kcl93/LED_Strahler/LED_Strahler_Case/LED_Strahler_Top.stl

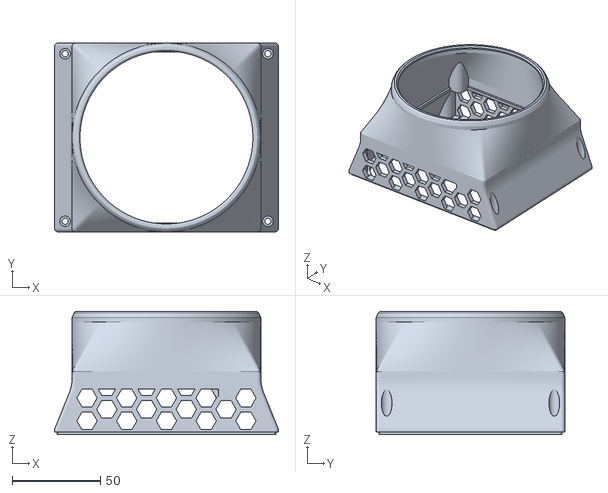
[picture p1: CAD file, 2020-01-30]
LED_Strahler_Case/LED_Strahler_Top.stl
127.0 x 107.0 x 69.9
