kcl93/LED_Strahler/LED_Strahler_Case/LED_Strahler_Bottom_NoDMX.stl

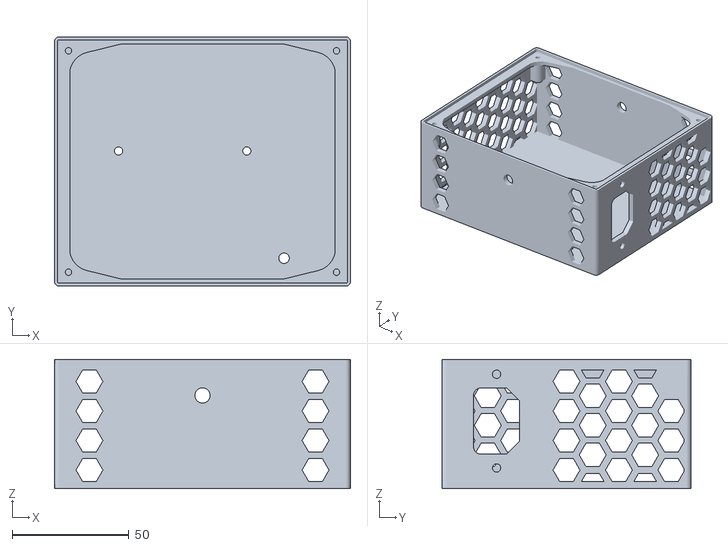
[picture p2: CAD file, 2020-01-22]
LED_Strahler_Case/LED_Strahler_Bottom_NoDMX.stl
127.0 x 107.0 x 55.5
