kcl93/LED_Strahler/LED_Strahler_Case/LED_Strahler_Reflektor.stl

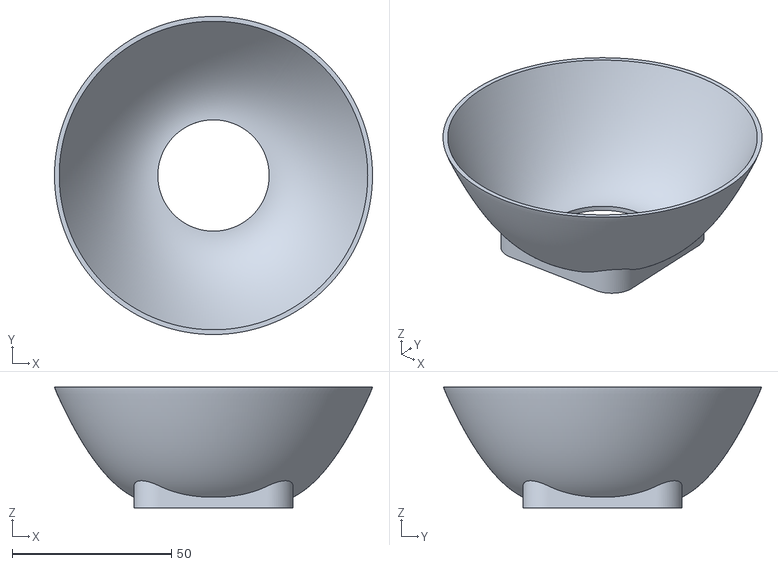
[picture p3: CAD file, 2020-01-22]
LED_Strahler_Case/LED_Strahler_Reflektor.stl
100.0 x 100.0 x 38.0
