kcl93/LED_Strahler/LED_Strahler_Case/Luefter_Stoepsel.stl

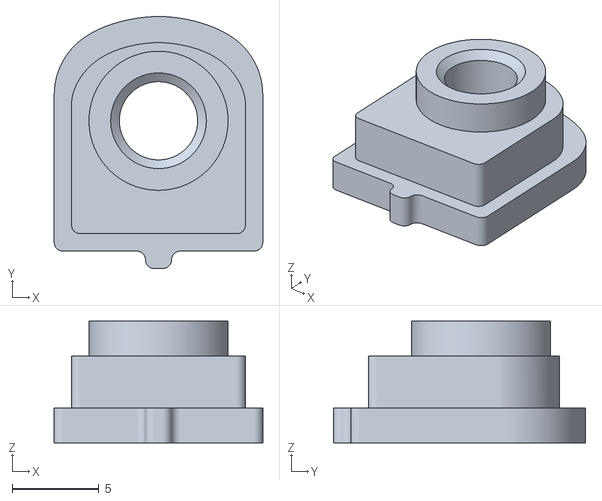
[picture p4: CAD file, 2020-01-22]
LED_Strahler_Case/Luefter_Stoepsel.stl
12.0 x 14.5 x 7.00
