kcl93/LED_Strahler/LED_Strahler_PCB/LED_Strahler/LED_Strahler.kicad_pcb

## KiCad design LED_Strahler_PCB/LED_Strahler/LED_Strahler.kicad_pcb (2020-01-12)

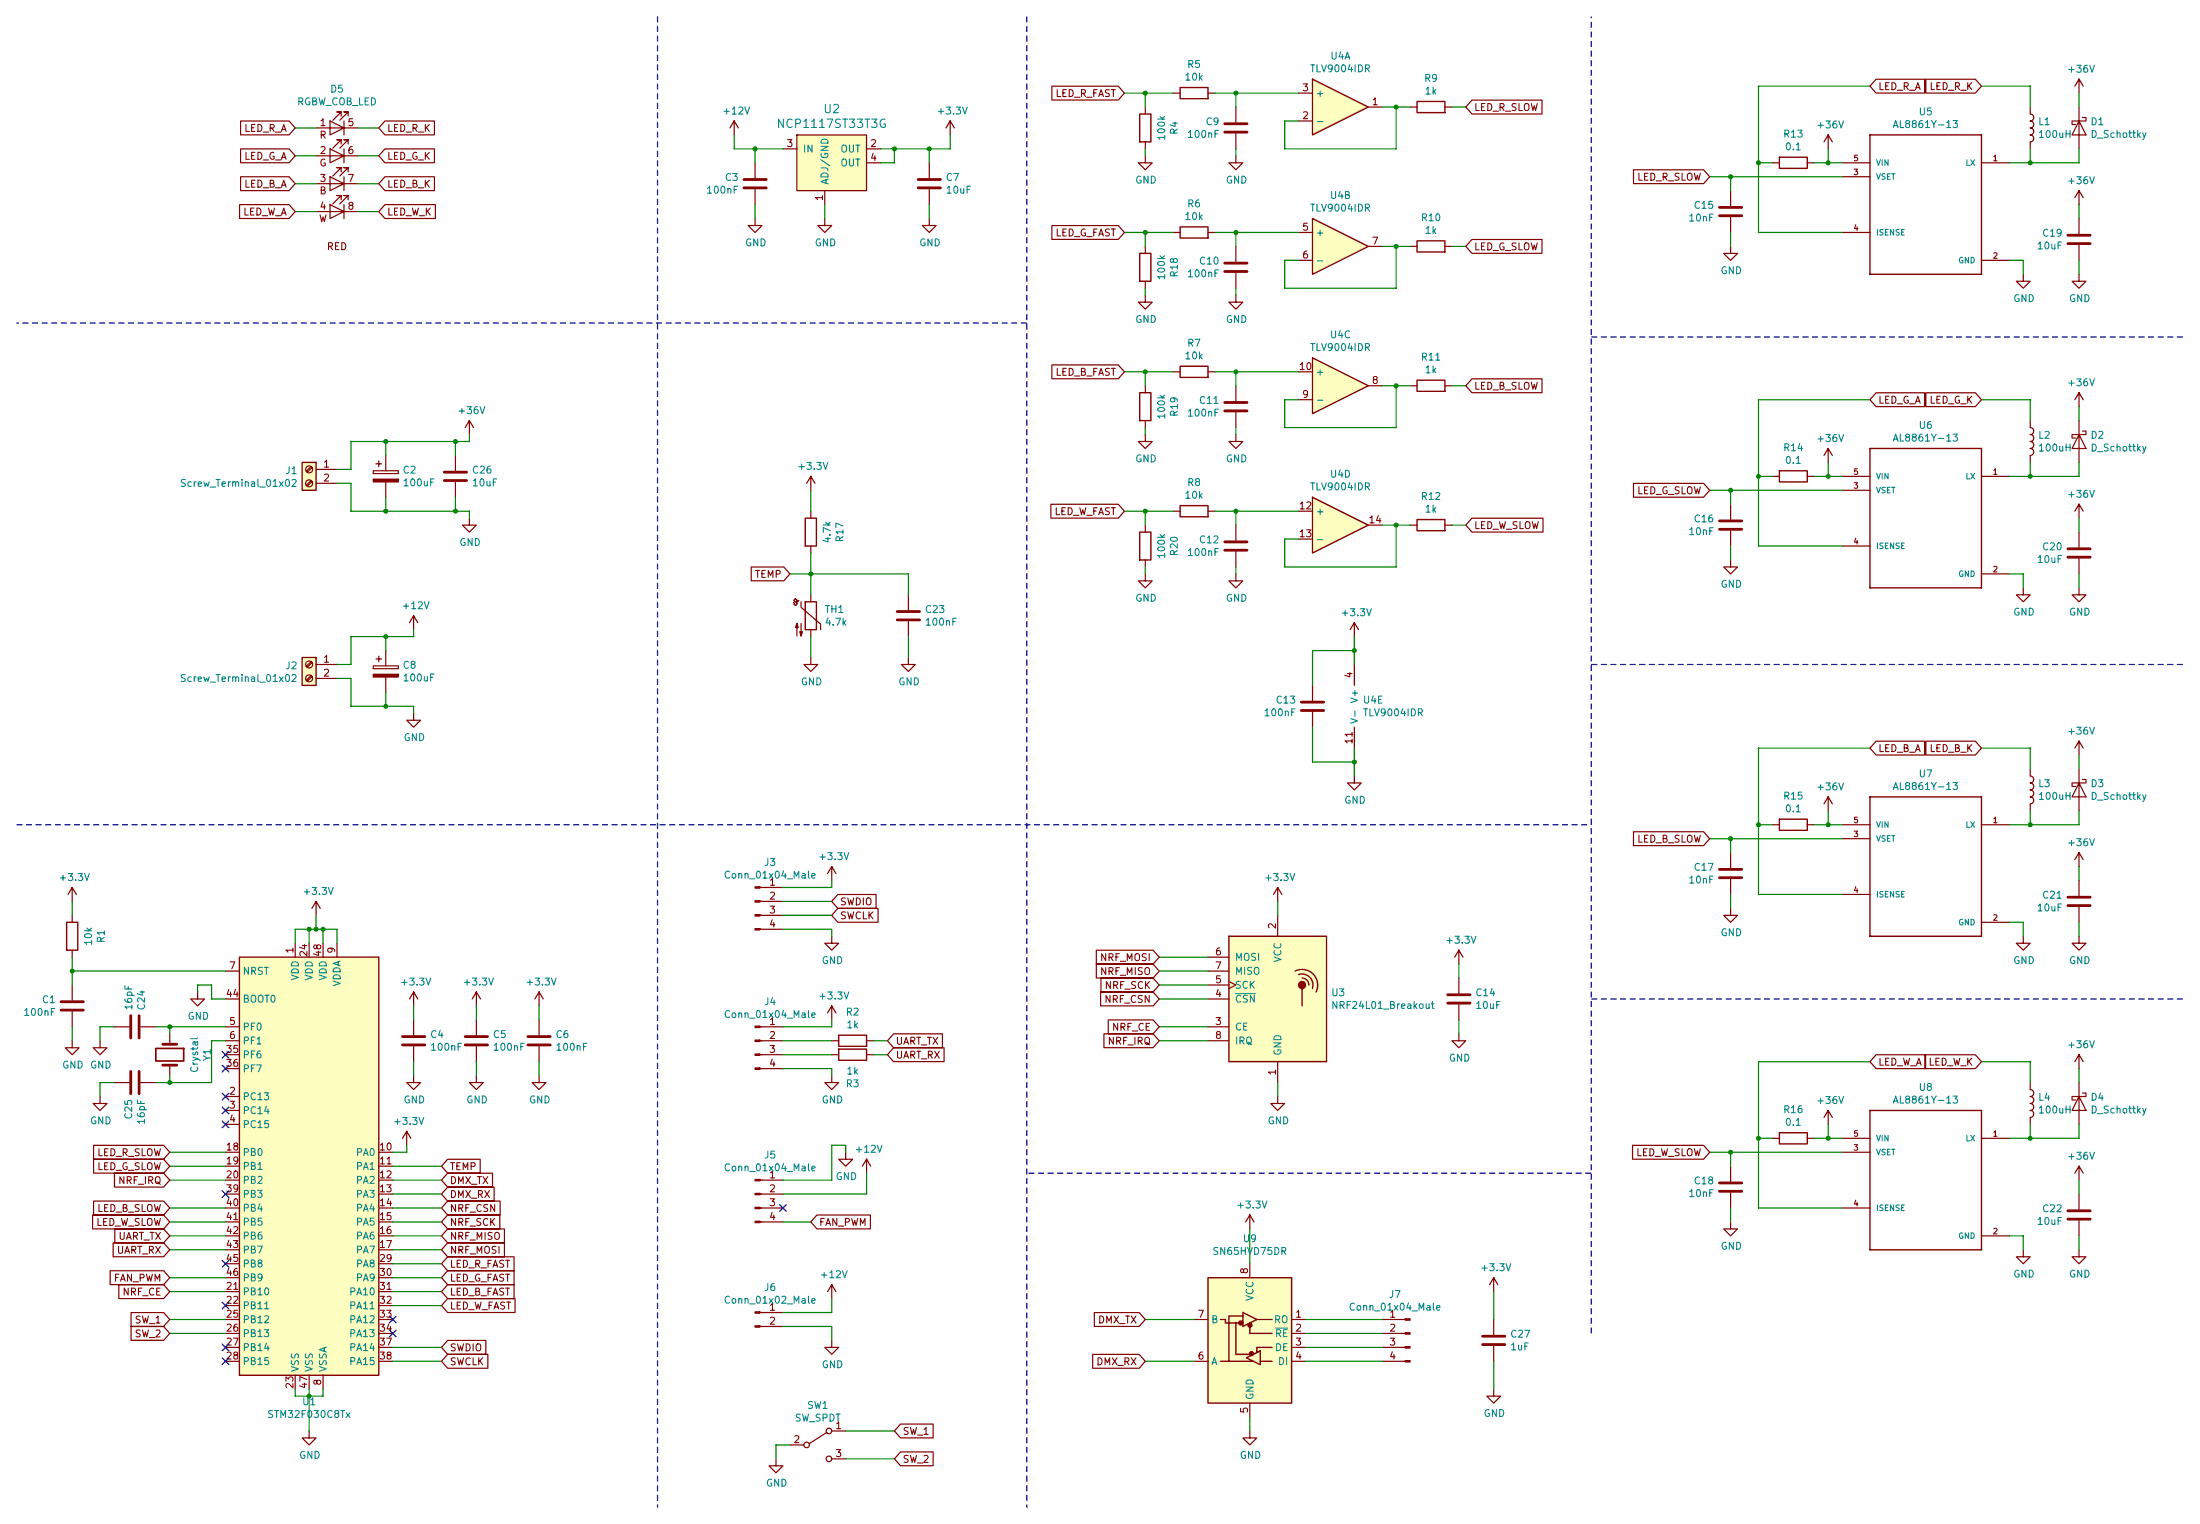
[picture p6: schematic LED_Strahler.sch, LED Strahler]

Parts:
C1, C3, C4, C5, C6, C9, C10, C11, C12, C13, C23: 100nF; C_0603_1608Metric_Pad1.05x0.95mm_HandSolder
C2, C8: 100uF; CP_Radial_D10.0mm_P5.00mm
C7, C14: 10uF; C_0805_2012Metric_Pad1.15x1.40mm_HandSolder
C15, C16, C17, C18: 10nF; C_0603_1608Metric_Pad1.05x0.95mm_HandSolder
C19, C20, C21, C22, C26: 10uF; C_1210_3225Metric_Pad1.42x2.65mm_HandSolder
C24, C25: 16pF; C_0603_1608Metric_Pad1.05x0.95mm_HandSolder
C27: 1uF; C_0805_2012Metric_Pad1.15x1.40mm_HandSolder
D1, D2, D3, D4: D_Schottky; D_SOD-123F
D5: RGBW_COB_LED; 50W_RGBW_COB_LED
J1, J2: Screw_Terminal_01x02; AMASS_XT30U-F_1x02_P5.0mm_Vertical
J3, J4, J7: Conn_01x04_Male; PinHeader_1x04_P2.54mm_Vertical
J5: Conn_01x04_Male; FanPinHeader_1x04_P2.54mm_Vertical
J6: Conn_01x02_Male; PinHeader_1x02_P2.54mm_Vertical
L1, L2, L3, L4: 100uH; L_Bourns_SRR1260
R1, R5, R6, R7, R8: 10k; R_0603_1608Metric_Pad1.05x0.95mm_HandSolder
R2, R3, R9, R10, R11, R12: 1k; R_0603_1608Metric_Pad1.05x0.95mm_HandSolder
R4, R18, R19, R20: 100k; R_0603_1608Metric_Pad1.05x0.95mm_HandSolder
R13, R14, R15, R16: 0.1; R_0805_2012Metric_Pad1.15x1.40mm_HandSolder
R17: 4.7k; R_0603_1608Metric_Pad1.05x0.95mm_HandSolder
SW1: SW_SPDT; SW_CuK_OS102011MA1QN1_SPDT_Angled
TH1: 4.7k; R_0603_1608Metric_Pad1.05x0.95mm_HandSolder
U1: STM32F030C8Tx; LQFP-48_7x7mm_P0.5mm
U2: NCP1117ST33T3G; SOT-223; MPN NCP1117ST33T3G; Digi-Key_PN NCP1117ST33T3GOSCT-ND
U3: NRF24L01_Breakout; nRF24L01_Breakout
U4: TLV9004IDR; SOIC-14_3.9x8.7mm_P1.27mm
U5, U6, U7, U8: AL8861Y-13; CONV_AL8861Y-13
U9: SN65HVD75DR; SOIC-8_3.9x4.9mm_P1.27mm
Y1: Crystal; Crystal_SMD_HC49-SD

Connections:
+3V3: C4.1, C5.1, C6.1, C7.1, C13.1, C14.1, C27.1, J3.1, J4.1, R1.1, R17.1, U1.1 (VDD), U1.9 (VDDA), U1.10 (PA0), U1.24 (VDD), U1.48 (VDD), U2.2 (OUT), U2.4 (OUT), U3.2 (VCC), U4.4 (V+), U9.8 (VCC)
+12V: C3.1, C8.1, J2.1, J5.2, J6.1, U2.3 (IN)
+36V: C2.1, C19.1, C20.1, C21.1, C22.1, C26.1, D1.1 (K), D2.1 (K), D3.1 (K), D4.1 (K), J1.1, R13.1, R14.1, R15.1, R16.1, U5.5 (VIN), U6.5 (VIN), U7.5 (VIN), U8.5 (VIN)
DMX_RX: U1.13 (PA3), U9.6 (A)
DMX_TX: U1.12 (PA2), U9.7 (B)
FAN_PWM: J5.4, U1.46 (PB9)
GND: C1.2, C2.2, C3.2, C4.2, C5.2, C6.2, C7.2, C8.2, C9.2, C10.2, C11.2, C12.2, C13.2, C14.2, C15.2, C16.2, C17.2, C18.2, C19.2, C20.2, C21.2, C22.2, C23.2, C24.2, C25.1, C26.2, C27.2, J1.2, J2.2, J3.4, J4.4, J5.1, J6.2, R4.2, R18.2, R19.2, R20.2, SW1.2 (B), TH1.2, U1.8 (VSSA), U1.23 (VSS), U1.44 (BOOT0), U1.47 (VSS), U2.1 (ADJ/GND), U3.1 (GND), U4.11 (V-), U5.2 (GND), U6.2 (GND), U7.2 (GND), U8.2 (GND), U9.5 (GND)
LED_B_A: D5.3 (A), R15.2, U7.4 (ISENSE)
LED_B_FAST: R7.1, R19.1, U1.31 (PA10)
LED_B_K: D5.7 (K), L3.1
LED_B_SLOW: C17.1, R11.2, U1.40 (PB4), U7.3 (VSET)
LED_G_A: D5.2 (A), R14.2, U6.4 (ISENSE)
LED_G_FAST: R6.1, R18.1, U1.30 (PA9)
LED_G_K: D5.6 (K), L2.1
LED_G_SLOW: C16.1, R10.2, U1.19 (PB1), U6.3 (VSET)
LED_R_A: D5.1 (A), R13.2, U5.4 (ISENSE)
LED_R_FAST: R4.1, R5.1, U1.29 (PA8)
LED_R_K: D5.5 (K), L1.1
LED_R_SLOW: C15.1, R9.2, U1.18 (PB0), U5.3 (VSET)
LED_W_A: D5.4 (A), R16.2, U8.4 (ISENSE)
LED_W_FAST: R8.1, R20.1, U1.32 (PA11)
LED_W_K: D5.8 (K), L4.1
LED_W_SLOW: C18.1, R12.2, U1.41 (PB5), U8.3 (VSET)
NRF_CE: U1.21 (PB10), U3.3 (CE)
NRF_CSN: U1.14 (PA4), U3.4 (~CSN)
NRF_IRQ: U1.20 (PB2), U3.8 (IRQ)
NRF_MISO: U1.16 (PA6), U3.7 (MISO)
NRF_MOSI: U1.17 (PA7), U3.6 (MOSI)
NRF_SCK: U1.15 (PA5), U3.5 (SCK)
unnamed: C1.1, R1.2, U1.7 (NRST)
unnamed: C9.1, R5.2, U4.3 (+)
unnamed: C10.1, R6.2, U4.5 (+)
unnamed: C11.1, R7.2, U4.10 (+)
unnamed: C12.1, R8.2, U4.12 (+)
unnamed: C24.1, U1.5 (PF0), Y1.1
unnamed: C25.2, U1.6 (PF1), Y1.2
unnamed: D1.2 (A), L1.2, U5.1 (LX)
unnamed: D2.2 (A), L2.2, U6.1 (LX)
unnamed: D3.2 (A), L3.2, U7.1 (LX)
unnamed: D4.2 (A), L4.2, U8.1 (LX)
unnamed: J4.2, R2.1
unnamed: J4.3, R3.2
unnamed: J7.1, U9.1 (RO)
unnamed: J7.2, U9.2 (~RE)
unnamed: J7.3, U9.3 (DE)
unnamed: J7.4, U9.4 (DI)
unnamed: R9.1, U4.1, U4.2 (-)
unnamed: R10.1, U4.6 (-), U4.7
unnamed: R11.1, U4.8, U4.9 (-)
unnamed: R12.1, U4.13 (-), U4.14
SWCLK: J3.3, U1.38 (PA15)
SWDIO: J3.2, U1.37 (PA14)
SW_1: SW1.1 (A), U1.25 (PB12)
SW_2: SW1.3 (C), U1.26 (PB13)
TEMP: C23.1, R17.2, TH1.1, U1.11 (PA1)
UART_RX: R3.1, U1.43 (PB7)
UART_TX: R2.2, U1.42 (PB6)

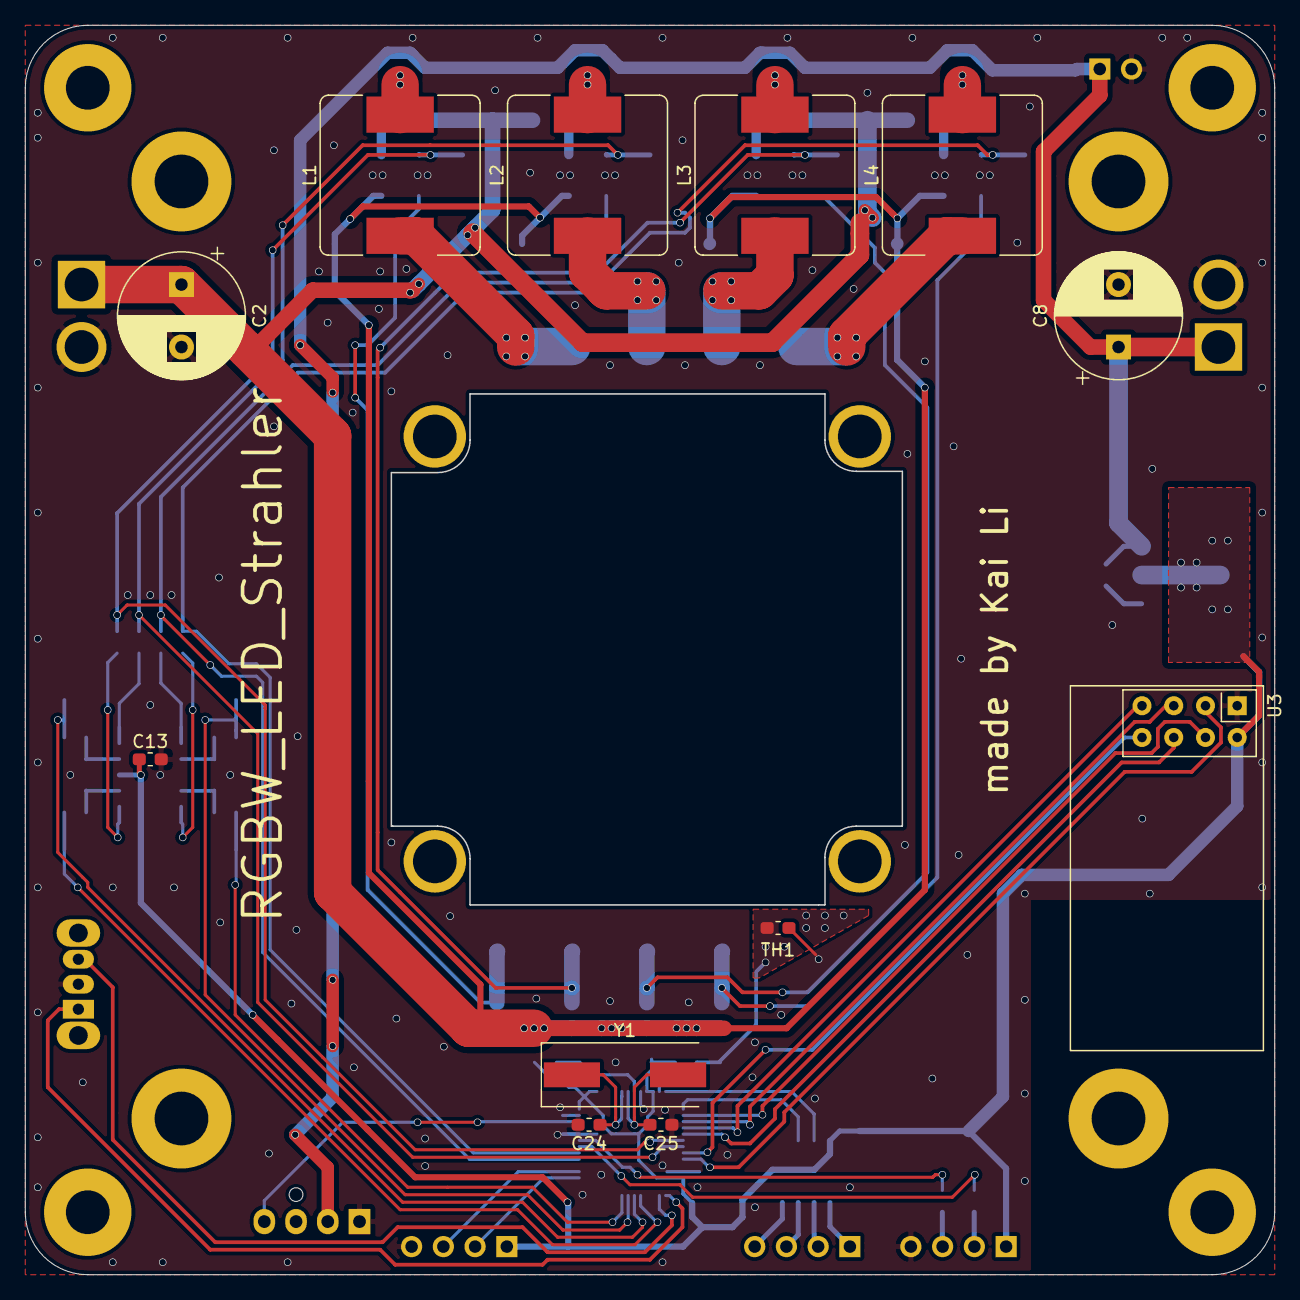
[picture p7: board LED_Strahler.kicad_pcb from above]

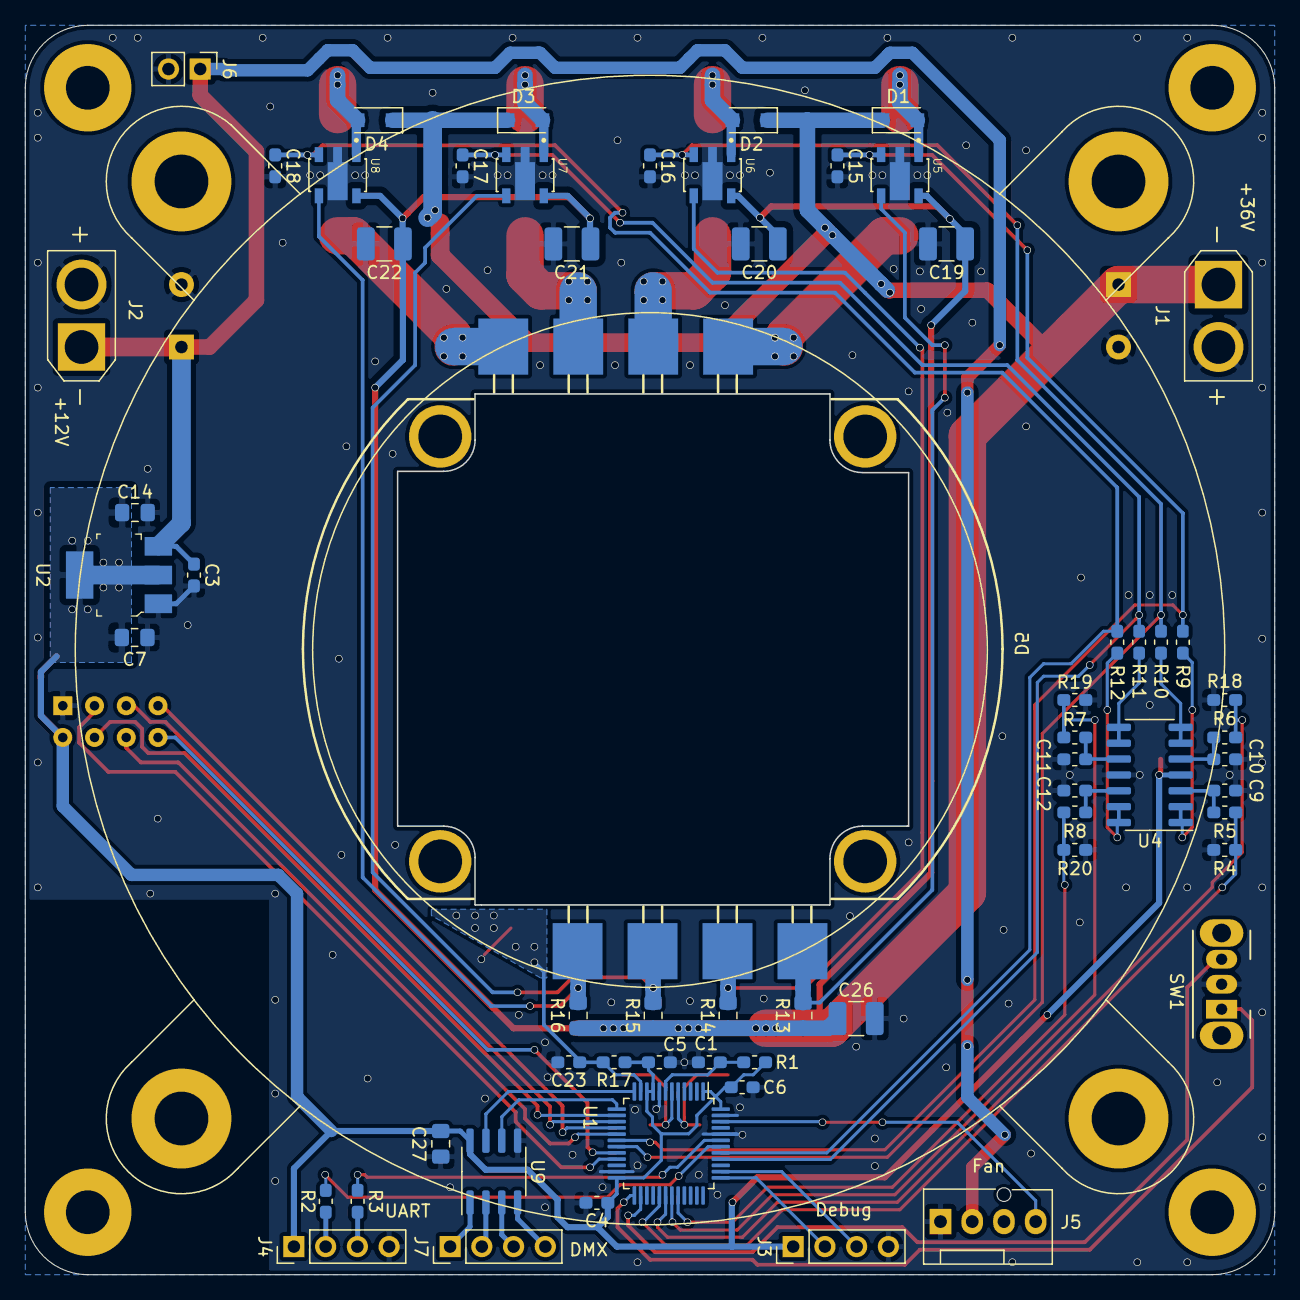
[picture p8: board LED_Strahler.kicad_pcb from below]

Board: 2 copper layers, 100.0 x 100.0 mm, 75 parts (62 on the bottom side), 57 nets.
