kcl93/LED_Strahler/LED_Strahler_FW/LED_Strahler/LED_Strahler.ioc

Mcu.UserName=STM32F030C8Tx
PA1.GPIO_Label=TEMP
PA1.Signal=ADC_IN1
PA10.GPIO_Label=LED_B_FAST
PA10.Signal=S_TIM1_CH3
PA11.GPIO_Label=LED_W_FAST
PA11.Signal=S_TIM1_CH4
PA13.Signal=SYS_SWDIO
PA14.Signal=SYS_SWCLK
PA2.GPIO_Label=DMX_TX
PA2.Signal=USART2_TX
PA3.GPIO_Label=DMX_RX
PA3.Signal=USART2_RX
PA4.GPIO_Label=NRF_CSN
PA4.Signal=GPIO_Output
PA5.GPIO_Label=NRF_SCK
PA5.Signal=SPI1_SCK
PA6.GPIO_Label=NRF_MISO
PA6.Signal=SPI1_MISO
PA7.GPIO_Label=NRF_MOSI
PA7.Signal=SPI1_MOSI
PA8.GPIO_Label=LED_R_FAST
PA8.Signal=S_TIM1_CH1
PA9.GPIO_Label=LED_G_FAST
PA9.Signal=S_TIM1_CH2
PB0.GPIO_Label=LED_R_SLOW
PB0.Signal=S_TIM3_CH3
PB1.GPIO_Label=LED_G_SLOW
PB1.Signal=S_TIM3_CH4
PB10.GPIO_Label=NRF_CE
PB10.Signal=GPIO_Output
PB12.GPIO_Label=SW_1
PB12.Signal=GPIO_Input
PB13.GPIO_Label=SW_2
PB13.Signal=GPIO_Input
PB2.GPIO_Label=NRF_IRQ
PB2.Signal=GPXTI2
PB4.GPIO_Label=LED_B_SLOW
PB4.Signal=S_TIM3_CH1
PB5.GPIO_Label=LED_W_SLOW
PB5.Signal=S_TIM3_CH2
PB6.GPIO_Label=UART_TX
PB6.Signal=USART1_TX
PB7.GPIO_Label=UART_RX
PB7.Signal=USART1_RX
PB9.GPIO_Label=FAN_PWM
PB9.Signal=S_TIM17_CH1
PF0-OSC_IN.GPIO_Label=OSC_IN
PF0-OSC_IN.Signal=RCC_OSC_IN
PF1-OSC_OUT.GPIO_Label=OSC_OUT
PF1-OSC_OUT.Signal=RCC_OSC_OUT
