kcl93/LED_Strahler/LED_Base_FW/LED_Strahler_Base/Core/Src/main.cpp

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

/* Includes ------------------------------------------------------------------*/
#include "main.h"

/* USER CODE BEGIN Includes */
#include "LED_Base.h"
/* USER CODE END Includes */

ADC_HandleTypeDef hadc2;

OPAMP_HandleTypeDef hopamp2;

SPI_HandleTypeDef hspi2;

UART_HandleTypeDef huart2;
UART_HandleTypeDef huart3;
DMA_HandleTypeDef hdma_usart2_rx;
DMA_HandleTypeDef hdma_usart2_tx;
DMA_HandleTypeDef hdma_usart3_rx;
DMA_HandleTypeDef hdma_usart3_tx;

void SystemClock_Config(void);
static void MX_GPIO_Init(void);
static void MX_USART2_UART_Init(void);
static void MX_DMA_Init(void);
static void MX_ADC2_Init(void);
static void MX_OPAMP2_Init(void);
static void MX_SPI2_Init(void);
static void MX_USART3_UART_Init(void);
/**
  * @brief  The application entry point.
  * @retval int
  */
int main(void)
{
  

  /* MCU Configuration--------------------------------------------------------*/

  /* Reset of all peripherals, Initializes the Flash interface and the Systick. */
  HAL_Init();

  /* Configure the system clock */
  SystemClock_Config();

  /* Initialize all configured peripherals */
  MX_GPIO_Init();
  MX_USART2_UART_Init();
  MX_DMA_Init();
  MX_ADC2_Init();
  MX_OPAMP2_Init();
  MX_SPI2_Init();
  MX_USART3_UART_Init();
  /* USER CODE BEGIN 2 */
  LED_Base_Setup();
  /* USER CODE END 2 */
 
 

  /* Infinite loop */
  /* USER CODE BEGIN WHILE */
  while (1)
  {
 	LED_Base_Handle();
    /* USER CODE END WHILE */

    /* USER CODE BEGIN 3 */
  }
  /* USER CODE END 3 */
}

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
