kcl93/LED_Strahler/LED_Base_FW/LED_Strahler_Base/Core/Inc/main.h

#define SW_MODE_Pin GPIO_PIN_13
#define SW_MODE_GPIO_Port GPIOC
#define BTN_PING_Pin GPIO_PIN_15
#define BTN_PING_GPIO_Port GPIOC
#define BT_EN_Pin GPIO_PIN_0
#define BT_EN_GPIO_Port GPIOC
#define BT_STA_Pin GPIO_PIN_1
#define BT_STA_GPIO_Port GPIOC
#define BT_TX_Pin GPIO_PIN_2
#define BT_TX_GPIO_Port GPIOA
#define BT_RX_Pin GPIO_PIN_3
#define BT_RX_GPIO_Port GPIOA
#define LED_GREEN_Pin GPIO_PIN_5
#define LED_GREEN_GPIO_Port GPIOA
#define OP_OUT_Pin GPIO_PIN_6
#define OP_OUT_GPIO_Port GPIOA
#define OP_INP_Pin GPIO_PIN_7
#define OP_INP_GPIO_Port GPIOA
#define NRF_IRQ_Pin GPIO_PIN_4
#define NRF_IRQ_GPIO_Port GPIOC
#define OP_INM_Pin GPIO_PIN_5
#define OP_INM_GPIO_Port GPIOC
#define NRF_CS_Pin GPIO_PIN_1
#define NRF_CS_GPIO_Port GPIOB
#define NRF_CE_Pin GPIO_PIN_2
#define NRF_CE_GPIO_Port GPIOB
#define NRF_CLK_Pin GPIO_PIN_13
#define NRF_CLK_GPIO_Port GPIOB
#define NRF_MISO_Pin GPIO_PIN_14
#define NRF_MISO_GPIO_Port GPIOB
#define NRF_MOSI_Pin GPIO_PIN_15
#define NRF_MOSI_GPIO_Port GPIOB
#define SWDIO_Pin GPIO_PIN_13
#define SWDIO_GPIO_Port GPIOA
#define SWDCLK_Pin GPIO_PIN_14
#define SWDCLK_GPIO_Port GPIOA
#define PC_TX_Pin GPIO_PIN_10
#define PC_TX_GPIO_Port GPIOC
#define PC_RX_Pin GPIO_PIN_11
#define PC_RX_GPIO_Port GPIOC
