kcl93/LED_Strahler/LED_Strahler_FW/LED_Strahler/Core/Src/stm32_nrf24l01.c

/**	
 * |----------------------------------------------------------------------
 * | Copyright (c) 2016 Tilen Majerle
 * |  
 * | Permission is hereby granted, free of charge, to any person
 * | obtaining a copy of this software and associated documentation
 * | files (the "Software"), to deal in the Software without restriction,
 * | including without limitation the rights to use, copy, modify, merge,
 * | publish, distribute, sublicense, and/or sell copies of the Software, 
 * | and to permit persons to whom the Software is furnished to do so, 
 * | subject to the following conditions:
 * | 
 * | The above copyright notice and this permission notice shall be
 * | included in all copies or substantial portions of the Software.
 * | 
 * | THE SOFTWARE IS PROVIDED "AS IS", WITHOUT WARRANTY OF ANY KIND,
 * | EXPRESS OR IMPLIED, INCLUDING BUT NOT LIMITED TO THE WARRANTIES
 * | OF MERCHANTABILITY, FITNESS FOR A PARTICULAR PURPOSE
 * | AND NONINFRINGEMENT. IN NO EVENT SHALL THE AUTHORS OR COPYRIGHT
 * | HOLDERS BE LIABLE FOR ANY CLAIM, DAMAGES OR OTHER LIABILITY,
 * | WHETHER IN AN ACTION OF CONTRACT, TORT OR OTHERWISE, ARISING 
 * | FROM, OUT OF OR IN CONNECTION WITH THE SOFTWARE OR THE USE OR
 * | OTHER DEALINGS IN THE SOFTWARE.
 * |----------------------------------------------------------------------
 */
#include "stm32_nrf24l01.h"



typedef struct {
	uint8_t PayloadSize;				//Payload size
	uint8_t Channel;					//Channel selected
	NRF24L01_OutputPower_t OutPwr;	//Output power
	NRF24L01_DataRate_t DataRate;	//Data rate
} NRF24L01_t;

/* Private functions */
void NRF24L01_InitPins(void);
void NRF24L01_WriteBit(uint8_t reg, uint8_t bit, uint8_t value);
uint8_t NRF24L01_ReadBit(uint8_t reg, uint8_t bit);
void NRF24L01_SoftwareReset(void);
uint8_t NRF24L01_RxFifoEmpty(void);

/* NRF structure */
static NRF24L01_t NRF24L01_Struct;

void NRF24L01_InitPins(void) {
	/* CSN high = disable SPI */
	NRF24L01_CSN_HIGH;
	
	/* CE low = disable TX/RX */
	NRF24L01_CE_LOW;
}

uint8_t NRF24L01_Init(uint8_t channel, uint8_t payload_size) {
	/* Initialize CE and CSN pins */
	NRF24L01_InitPins();
	
	/* Max payload is 32bytes */
	if (payload_size > 32) {
		payload_size = 32;
	}
	
	/* Fill structure */
	NRF24L01_Struct.Channel = !channel; /* Set channel to some different value for NRF24L01_SetChannel() function */
	NRF24L01_Struct.PayloadSize = payload_size;
	NRF24L01_Struct.OutPwr = NRF24L01_OutputPower_0dBm;
	NRF24L01_Struct.DataRate = NRF24L01_DataRate_1M;
	
	/* Reset nRF24L01+ to power on registers values */
	NRF24L01_SoftwareReset();
	
	NRF24L01_GetStatus();

	/* Channel select */
	NRF24L01_SetChannel(channel);
	
	/* Set pipeline to max possible 32 bytes */
	NRF24L01_WriteRegister(NRF24L01_REG_RX_PW_P0, NRF24L01_Struct.PayloadSize); // Auto-ACK pipe
	NRF24L01_WriteRegister(NRF24L01_REG_RX_PW_P1, NRF24L01_Struct.PayloadSize); // Data payload pipe
	NRF24L01_WriteRegister(NRF24L01_REG_RX_PW_P2, NRF24L01_Struct.PayloadSize);
	NRF24L01_WriteRegister(NRF24L01_REG_RX_PW_P3, NRF24L01_Struct.PayloadSize);
	NRF24L01_WriteRegister(NRF24L01_REG_RX_PW_P4, NRF24L01_Struct.PayloadSize);
	NRF24L01_WriteRegister(NRF24L01_REG_RX_PW_P5, NRF24L01_Struct.PayloadSize);
	
	/* Set RF settings (1mbps, output power) */
	NRF24L01_SetRF(NRF24L01_Struct.DataRate, NRF24L01_Struct.OutPwr);
	
	/* Config register */
	NRF24L01_WriteRegister(NRF24L01_REG_CONFIG, NRF24L01_CONFIG);
	
	/* Enable auto-acknowledgment for all pipes */
	//NRF24L01_WriteRegister(NRF24L01_REG_EN_AA, 0x3F);

	/* Disable auto-acknowledgment for all pipes */
	NRF24L01_WriteRegister(NRF24L01_REG_EN_AA, 0x00);
	
	/* Enable RX addresses */
	//NRF24L01_WriteRegister(NRF24L01_REG_EN_RXADDR, 0x3F);

	/* Disable RX addresses beside pipeline 0 and 1 */
	NRF24L01_WriteRegister(NRF24L01_REG_EN_RXADDR, (1 << NRF24L01_ERX_P0) | (1 << NRF24L01_ERX_P1));

	/* Auto retransmit delay: 1000 (4x250) us and Up to 15 retransmit trials */
	//NRF24L01_WriteRegister(NRF24L01_REG_SETUP_RETR, 0x4F);
	NRF24L01_WriteRegister(NRF24L01_REG_SETUP_RETR, 0x00);
	
	/* Dynamic length configurations: No dynamic length */
	NRF24L01_WriteRegister(NRF24L01_REG_DYNPD, (0 << NRF24L01_DPL_P0) | (0 << NRF24L01_DPL_P1) | (0 << NRF24L01_DPL_P2) | (0 << NRF24L01_DPL_P3) | (0 << NRF24L01_DPL_P4) | (0 << NRF24L01_DPL_P5));
	
	// Set address length to 4 bytes
	NRF24L01_WriteRegister(NRF24L01_REG_SETUP_AW, (0x02 << NRF24L01_AW));

	//Enable dynamic ACK
	NRF24L01_WriteRegister(NRF24L01_REG_FEATURE, 0x01);

	/* Clear FIFOs */
	NRF24L01_FLUSH_TX;
	NRF24L01_FLUSH_RX;
	
	/* Clear interrupts */
	NRF24L01_Clear_Interrupts();
	
	/* Go to RX mode */
	NRF24L01_PowerUpRx();
	
	/* Return OK */
	return 1;
}

void NRF24L01_SetMyAddress(uint8_t *adr) {
	NRF24L01_CE_LOW;
	NRF24L01_WriteRegisterMulti(NRF24L01_REG_RX_ADDR_P1, adr, 5);
	NRF24L01_CE_HIGH;
}

void NRF24L01_SetTxAddress(uint8_t *adr) {
	NRF24L01_WriteRegisterMulti(NRF24L01_REG_RX_ADDR_P0, adr, 5);
	NRF24L01_WriteRegisterMulti(NRF24L01_REG_TX_ADDR, adr, 5);
}

void NRF24L01_WriteBit(uint8_t reg, uint8_t bit, uint8_t value) {
	uint8_t tmp;
	/* Read register */
	tmp = NRF24L01_ReadRegister(reg);
	/* Make operation */
	if (value) {
		tmp |= 1 << bit;
	} else {
		tmp &= ~(1 << bit);
	}
	/* Write back */
	NRF24L01_WriteRegister(reg, tmp);
}

uint8_t NRF24L01_ReadBit(uint8_t reg, uint8_t bit) {
	uint8_t tmp;
	tmp = NRF24L01_ReadRegister(reg);
	if (!NRF24L01_CHECK_BIT(tmp, bit)) {
		return 0;
	}
	return 1;
}

uint8_t NRF24L01_ReadRegister(uint8_t reg) {
	uint8_t Data[2];
	Data[0] = NRF24L01_READ_REGISTER_MASK(reg);
	Data[1] = 0;
	NRF24L01_CSN_LOW;
	NRF24L01_SPI_SendMulti(Data, Data, 2);
	NRF24L01_CSN_HIGH;
	return Data[1];
}

void NRF24L01_ReadRegisterMulti(uint8_t reg, uint8_t* data, uint8_t count)
{
	NRF24L01_CSN_LOW;
	NRF24L01_SPI_Send(NRF24L01_READ_REGISTER_MASK(reg));
	NRF24L01_SPI_ReadMulti(data, NRF24L01_NOP_MASK, count);
	NRF24L01_CSN_HIGH;
}

uint8_t NRF24L01_WriteRegister(uint8_t reg, uint8_t value)
{
	uint8_t Data[2];
	Data[0] = NRF24L01_WRITE_REGISTER_MASK(reg);
	Data[1] = value;
	NRF24L01_CSN_LOW;
	NRF24L01_SPI_SendMulti(Data, Data, 2);
	NRF24L01_CSN_HIGH;
	return Data[0];
}

void NRF24L01_WriteRegisterMulti(uint8_t reg, uint8_t *data, uint8_t count) {
	NRF24L01_CSN_LOW;
	NRF24L01_SPI_Send(NRF24L01_WRITE_REGISTER_MASK(reg));
	NRF24L01_SPI_WriteMulti(data, count);
	NRF24L01_CSN_HIGH;
}

void NRF24L01_PowerUpTx(void) {
	// Check if Tx is alread active
	uint8_t reg = NRF24L01_ReadRegister(NRF24L01_REG_CONFIG);
	if(!(reg & (1 << NRF24L01_PWR_UP)) || (reg & (1 << NRF24L01_PRIM_RX)))
	{
		/* Disable RX/TX mode */
		NRF24L01_CE_LOW;
		/* Clear RX buffer */
		NRF24L01_FLUSH_TX;
		/* Clear interrupts */
		NRF24L01_Clear_Interrupts();
		/* Setup RX mode */
		NRF24L01_WriteRegister(NRF24L01_REG_CONFIG, NRF24L01_CONFIG | (0 << NRF24L01_PRIM_RX) | (1 << NRF24L01_PWR_UP));
		/* Start listening */
		NRF24L01_CE_HIGH;
	}
}

void NRF24L01_PowerUpRx(void) {
	// Check if Rx is alread active
	uint8_t reg = NRF24L01_ReadRegister(NRF24L01_REG_CONFIG);
	if(!(reg & (1 << NRF24L01_PWR_UP)) || !(reg & (1 << NRF24L01_PRIM_RX)))
	{
		/* Disable RX/TX mode */
		NRF24L01_CE_LOW;
		/* Clear RX buffer */
		NRF24L01_FLUSH_RX;
		/* Clear interrupts */
		NRF24L01_Clear_Interrupts();
		/* Setup RX mode */
		NRF24L01_WriteRegister(NRF24L01_REG_CONFIG, NRF24L01_CONFIG | 1 << NRF24L01_PWR_UP | 1 << NRF24L01_PRIM_RX);
		/* Start listening */
		NRF24L01_CE_HIGH;
	}
}

void NRF24L01_PowerDown(void) {
	NRF24L01_CE_LOW;
	NRF24L01_WriteBit(NRF24L01_REG_CONFIG, NRF24L01_PWR_UP, 0);
}

void NRF24L01_Transmit(uint8_t *data) {
	uint8_t count = NRF24L01_Struct.PayloadSize;

	/* Chip enable put to low, disable it */
	//NRF24L01_CE_LOW;
	
	/* Go to power up tx mode */
	NRF24L01_PowerUpTx();
	
	/* Clear TX FIFO from NRF24L01+ */
	NRF24L01_FLUSH_TX;
	
	/* Send payload to nRF24L01+ */
	NRF24L01_CSN_LOW;
	/* Send write payload command */
	//NRF24L01_SPI_Send(NRF24L01_W_TX_PAYLOAD_MASK);
	NRF24L01_SPI_Send(NRF24L01_W_TX_PAYLOAD_NOACK_MASK);
	/* Fill payload with data*/
	NRF24L01_SPI_WriteMulti(data, count);
	/* Disable SPI */
	NRF24L01_CSN_HIGH;
	
	/* Send data! */
	NRF24L01_CE_HIGH;
}

void NRF24L01_GetData(uint8_t* data) {
	/* Pull down chip select */
	NRF24L01_CSN_LOW;
	/* Send read payload command*/
	NRF24L01_SPI_Send(NRF24L01_R_RX_PAYLOAD_MASK);
	/* Read payload */
	NRF24L01_SPI_SendMulti(data, data, NRF24L01_Struct.PayloadSize);
	/* Pull up chip select */
	NRF24L01_CSN_HIGH;
	
	/* Reset status register, clear RX_DR interrupt flag */
	//NRF24L01_WriteRegister(NRF24L01_REG_STATUS, (1 << NRF24L01_RX_DR));
}

uint8_t NRF24L01_DataReady(void) {
	uint8_t status = NRF24L01_GetStatus();
	
	if (NRF24L01_CHECK_BIT(status, NRF24L01_RX_DR)) {
		return 1;
	}
	return !NRF24L01_RxFifoEmpty();
}

uint8_t NRF24L01_RxFifoEmpty(void) {
	uint8_t reg = NRF24L01_ReadRegister(NRF24L01_REG_FIFO_STATUS);
	return NRF24L01_CHECK_BIT(reg, NRF24L01_RX_EMPTY);
}

uint8_t NRF24L01_GetStatus(void) {
	uint8_t Data;
	
	NRF24L01_CSN_LOW;
	/* First received byte is always status register */
	Data = NRF24L01_SPI_Send(NRF24L01_READ_REGISTER_MASK(NRF24L01_REG_STATUS));
	/* Pull up chip select */
	NRF24L01_CSN_HIGH;
	
	return Data;
}

NRF24L01_Transmit_Status_t NRF24L01_GetTransmissionStatus(void) {
	uint8_t status = NRF24L01_GetStatus();
	if (NRF24L01_CHECK_BIT(status, NRF24L01_TX_DS)) {
		/* Successfully sent */
		return NRF24L01_Transmit_Status_Ok;
	} else if (NRF24L01_CHECK_BIT(status, NRF24L01_MAX_RT)) {
		/* Message lost */
		return NRF24L01_Transmit_Status_Lost;
	}
	
	/* Still sending */
	return NRF24L01_Transmit_Status_Sending;
}

void NRF24L01_SoftwareReset(void) {
	uint8_t data[5];
	
	//Disable chip
	NRF24L01_CE_LOW;
	//Flush rx and Flush tx
	NRF24L01_CSN_LOW;
	NRF24L01_SPI_Send(NRF24L01_FLUSH_TX_MASK);
	NRF24L01_CSN_HIGH;
	NRF24L01_CSN_LOW;
	NRF24L01_SPI_Send(NRF24L01_FLUSH_RX_MASK);
	NRF24L01_CSN_HIGH;

	NRF24L01_WriteRegister(NRF24L01_REG_CONFIG, 		NRF24L01_REG_DEFAULT_VAL_CONFIG);
	NRF24L01_WriteRegister(NRF24L01_REG_EN_AA,		NRF24L01_REG_DEFAULT_VAL_EN_AA);
	NRF24L01_WriteRegister(NRF24L01_REG_EN_RXADDR, 	NRF24L01_REG_DEFAULT_VAL_EN_RXADDR);
	NRF24L01_WriteRegister(NRF24L01_REG_SETUP_AW, 	NRF24L01_REG_DEFAULT_VAL_SETUP_AW);
	NRF24L01_WriteRegister(NRF24L01_REG_SETUP_RETR, 	NRF24L01_REG_DEFAULT_VAL_SETUP_RETR);
	NRF24L01_WriteRegister(NRF24L01_REG_RF_CH, 		NRF24L01_REG_DEFAULT_VAL_RF_CH);
	NRF24L01_WriteRegister(NRF24L01_REG_RF_SETUP, 	NRF24L01_REG_DEFAULT_VAL_RF_SETUP);
	NRF24L01_WriteRegister(NRF24L01_REG_STATUS, 		NRF24L01_REG_DEFAULT_VAL_STATUS);
	NRF24L01_WriteRegister(NRF24L01_REG_OBSERVE_TX, 	NRF24L01_REG_DEFAULT_VAL_OBSERVE_TX);
	NRF24L01_WriteRegister(NRF24L01_REG_RPD, 		NRF24L01_REG_DEFAULT_VAL_RPD);
	
	//P0
	data[0] = NRF24L01_REG_DEFAULT_VAL_RX_ADDR_P0_0;
	data[1] = NRF24L01_REG_DEFAULT_VAL_RX_ADDR_P0_1;
	data[2] = NRF24L01_REG_DEFAULT_VAL_RX_ADDR_P0_2;
	data[3] = NRF24L01_REG_DEFAULT_VAL_RX_ADDR_P0_3;
	data[4] = NRF24L01_REG_DEFAULT_VAL_RX_ADDR_P0_4;
	NRF24L01_WriteRegisterMulti(NRF24L01_REG_RX_ADDR_P0, data, 5);
	
	//P1
	data[0] = NRF24L01_REG_DEFAULT_VAL_RX_ADDR_P1_0;
	data[1] = NRF24L01_REG_DEFAULT_VAL_RX_ADDR_P1_1;
	data[2] = NRF24L01_REG_DEFAULT_VAL_RX_ADDR_P1_2;
	data[3] = NRF24L01_REG_DEFAULT_VAL_RX_ADDR_P1_3;
	data[4] = NRF24L01_REG_DEFAULT_VAL_RX_ADDR_P1_4;
	NRF24L01_WriteRegisterMulti(NRF24L01_REG_RX_ADDR_P1, data, 5);
	
	NRF24L01_WriteRegister(NRF24L01_REG_RX_ADDR_P2, 	NRF24L01_REG_DEFAULT_VAL_RX_ADDR_P2);
	NRF24L01_WriteRegister(NRF24L01_REG_RX_ADDR_P3, 	NRF24L01_REG_DEFAULT_VAL_RX_ADDR_P3);
	NRF24L01_WriteRegister(NRF24L01_REG_RX_ADDR_P4, 	NRF24L01_REG_DEFAULT_VAL_RX_ADDR_P4);
	NRF24L01_WriteRegister(NRF24L01_REG_RX_ADDR_P5, 	NRF24L01_REG_DEFAULT_VAL_RX_ADDR_P5);
	
	//TX
	data[0] = NRF24L01_REG_DEFAULT_VAL_TX_ADDR_0;
	data[1] = NRF24L01_REG_DEFAULT_VAL_TX_ADDR_1;
	data[2] = NRF24L01_REG_DEFAULT_VAL_TX_ADDR_2;
	data[3] = NRF24L01_REG_DEFAULT_VAL_TX_ADDR_3;
	data[4] = NRF24L01_REG_DEFAULT_VAL_TX_ADDR_4;
	NRF24L01_WriteRegisterMulti(NRF24L01_REG_TX_ADDR, data, 5);
	
	NRF24L01_WriteRegister(NRF24L01_REG_RX_PW_P0, 	NRF24L01_REG_DEFAULT_VAL_RX_PW_P0);
	NRF24L01_WriteRegister(NRF24L01_REG_RX_PW_P1, 	NRF24L01_REG_DEFAULT_VAL_RX_PW_P1);
	NRF24L01_WriteRegister(NRF24L01_REG_RX_PW_P2, 	NRF24L01_REG_DEFAULT_VAL_RX_PW_P2);
	NRF24L01_WriteRegister(NRF24L01_REG_RX_PW_P3, 	NRF24L01_REG_DEFAULT_VAL_RX_PW_P3);
	NRF24L01_WriteRegister(NRF24L01_REG_RX_PW_P4, 	NRF24L01_REG_DEFAULT_VAL_RX_PW_P4);
	NRF24L01_WriteRegister(NRF24L01_REG_RX_PW_P5, 	NRF24L01_REG_DEFAULT_VAL_RX_PW_P5);
	NRF24L01_WriteRegister(NRF24L01_REG_FIFO_STATUS, NRF24L01_REG_DEFAULT_VAL_FIFO_STATUS);
	NRF24L01_WriteRegister(NRF24L01_REG_DYNPD, 		NRF24L01_REG_DEFAULT_VAL_DYNPD);
	NRF24L01_WriteRegister(NRF24L01_REG_FEATURE, 	NRF24L01_REG_DEFAULT_VAL_FEATURE);
}

uint8_t NRF24L01_GetRetransmissionsCount(void) {
	/* Low 4 bits */
	return NRF24L01_ReadRegister(NRF24L01_REG_OBSERVE_TX) & 0x0F;
}

void NRF24L01_SetChannel(uint8_t channel) {
	if (channel <= 125 && channel != NRF24L01_Struct.Channel) {
		/* Store new channel setting */
		NRF24L01_Struct.Channel = channel;
		/* Write channel */
		NRF24L01_WriteRegister(NRF24L01_REG_RF_CH, channel);
	}
}

void NRF24L01_SetRF(NRF24L01_DataRate_t DataRate, NRF24L01_OutputPower_t OutPwr) {
	uint8_t tmp = 0;
	NRF24L01_Struct.DataRate = DataRate;
	NRF24L01_Struct.OutPwr = OutPwr;
	
	if (DataRate == NRF24L01_DataRate_2M) {
		tmp |= 1 << NRF24L01_RF_DR_HIGH;
	} else if (DataRate == NRF24L01_DataRate_250k) {
		tmp |= 1 << NRF24L01_RF_DR_LOW;
	}
	/* If 1Mbps, all bits set to 0 */
	
	if (OutPwr == NRF24L01_OutputPower_0dBm) {
		tmp |= 3 << NRF24L01_RF_PWR;
	} else if (OutPwr == NRF24L01_OutputPower_M6dBm) {
		tmp |= 2 << NRF24L01_RF_PWR;
	} else if (OutPwr == NRF24L01_OutputPower_M12dBm) {
		tmp |= 1 << NRF24L01_RF_PWR;
	}
	
	NRF24L01_WriteRegister(NRF24L01_REG_RF_SETUP, tmp);
}

uint8_t NRF24L01_Read_Interrupts(NRF24L01_IRQ_t* IRQ) {
	IRQ->Status = NRF24L01_GetStatus();
	return IRQ->Status;
}

uint8_t NRF24L01_Clear_Interrupts(void) {
	return NRF24L01_WriteRegister(0x07, 0x70);
}
