kcl93/LED_Strahler/(commit log)

2020-01-12 Updated FAN startup.
2020-01-13 Got RF-link working!
    [LED_Strahler_RF_Commands.xlsx]
2020-01-22 Add 3D models for case
    [LED_Strahler_Bottom.stl, LED_Strahler_Bottom_NoDMX.stl, LED_Strahler_Reflektor.stl, LED_Strahler_Top.stl, Luefter_Stoepsel.stl]
2020-01-30 Various fixes & improvements
    [LED_Strahler_Top.stl]
2020-02-01 Fixed ping and getTemp. Repo cleanup.
    [LED_Base.cpp, LED_NRF24L01.cpp, LED_SerialParser.cpp, LED_Strahler_Base.ioc, main.cpp, main.h, stm32_nrf24l01.c]
2020-02-02 Fixed read temp. Various fixes and improvements.
    [LED_Base.cpp, LED_NRF24L01.cpp]
2020-02-05 Improved LED fading
2020-03-29 Fixed PWM to have a linear duty cycle.
    [LED_PWM.cpp, LED_PWM.h, LED_StateMachine.cpp, LED_StateMachine.h]
2020-04-06 Added option to set individual LED strahler only. Did some more prework for music and LJ control in the windows app.
